dblanding/PicoBot-oto/imgs/arena_map0.png

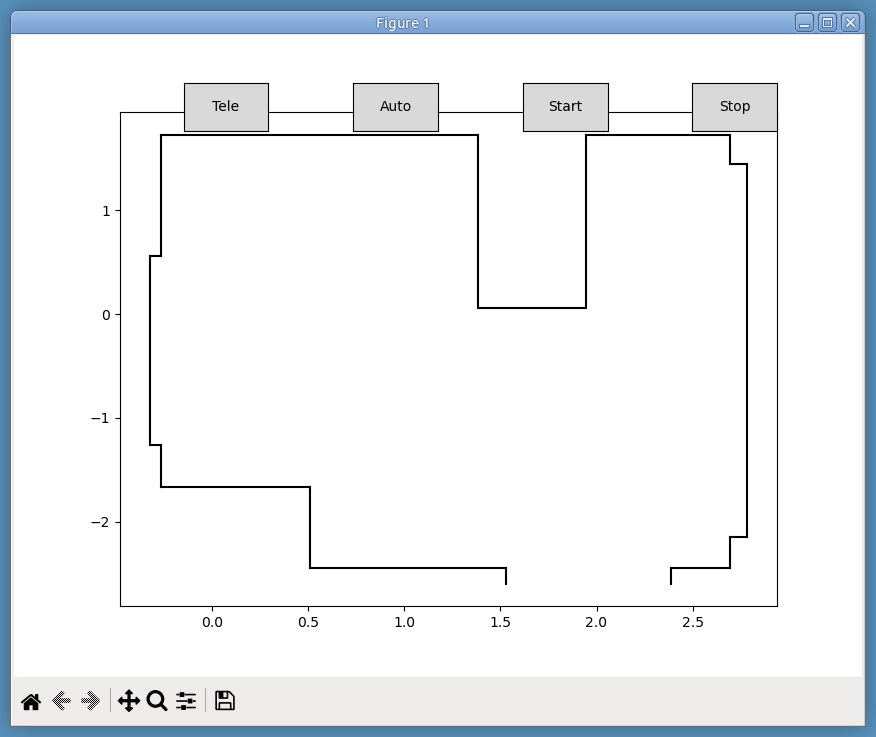
imgs/arena_map0.png
