dblanding/PicoBot-oto/imgs/arena_map1.png

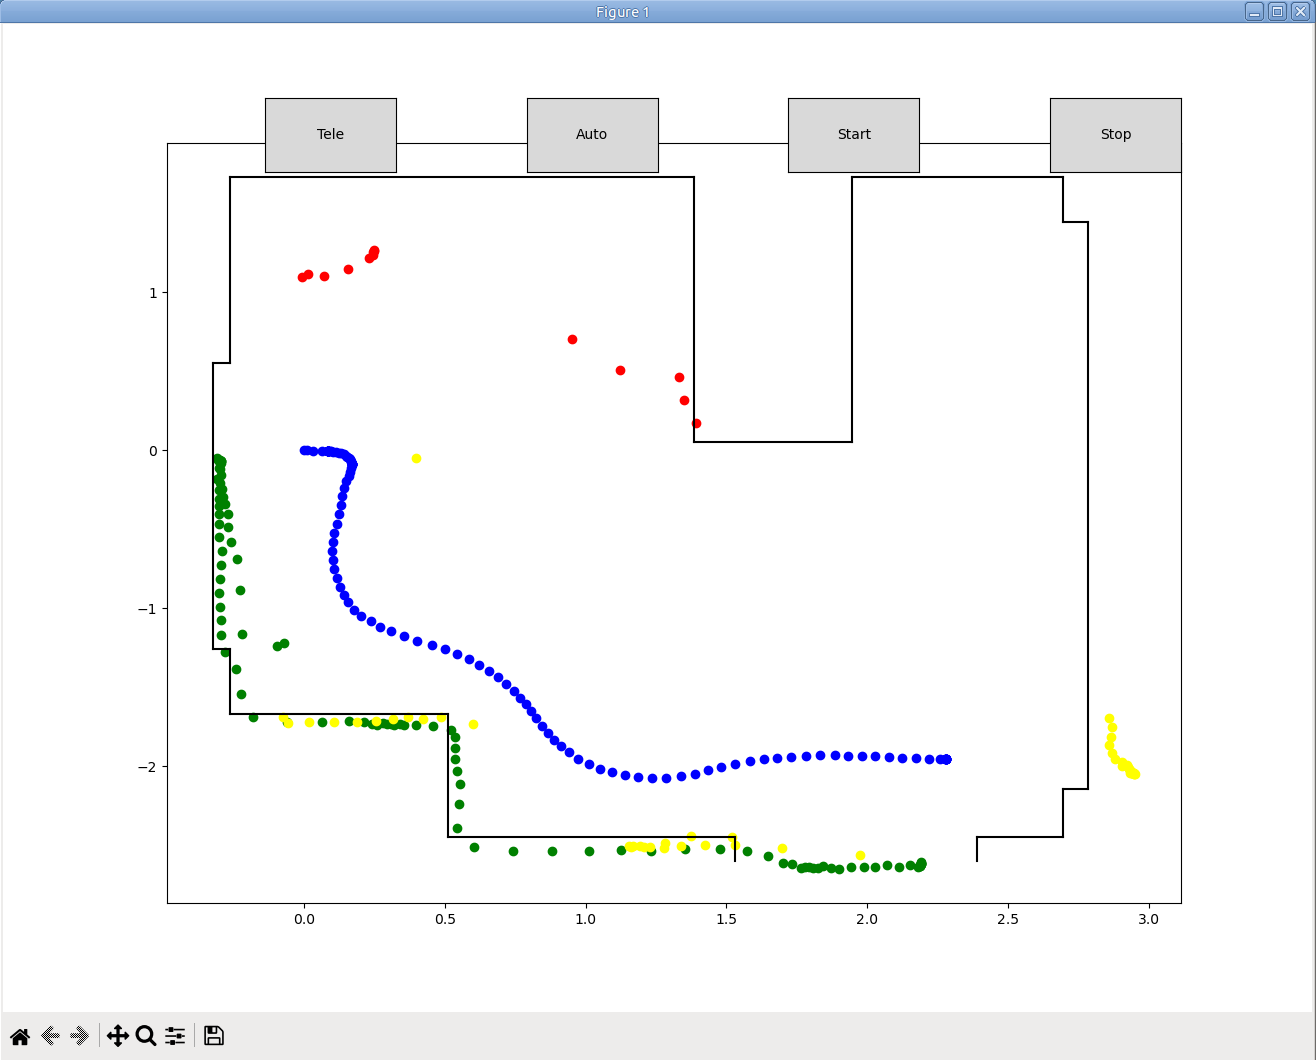
imgs/arena_map1.png
