dblanding/PicoBot-oto/imgs/arena_map2.png

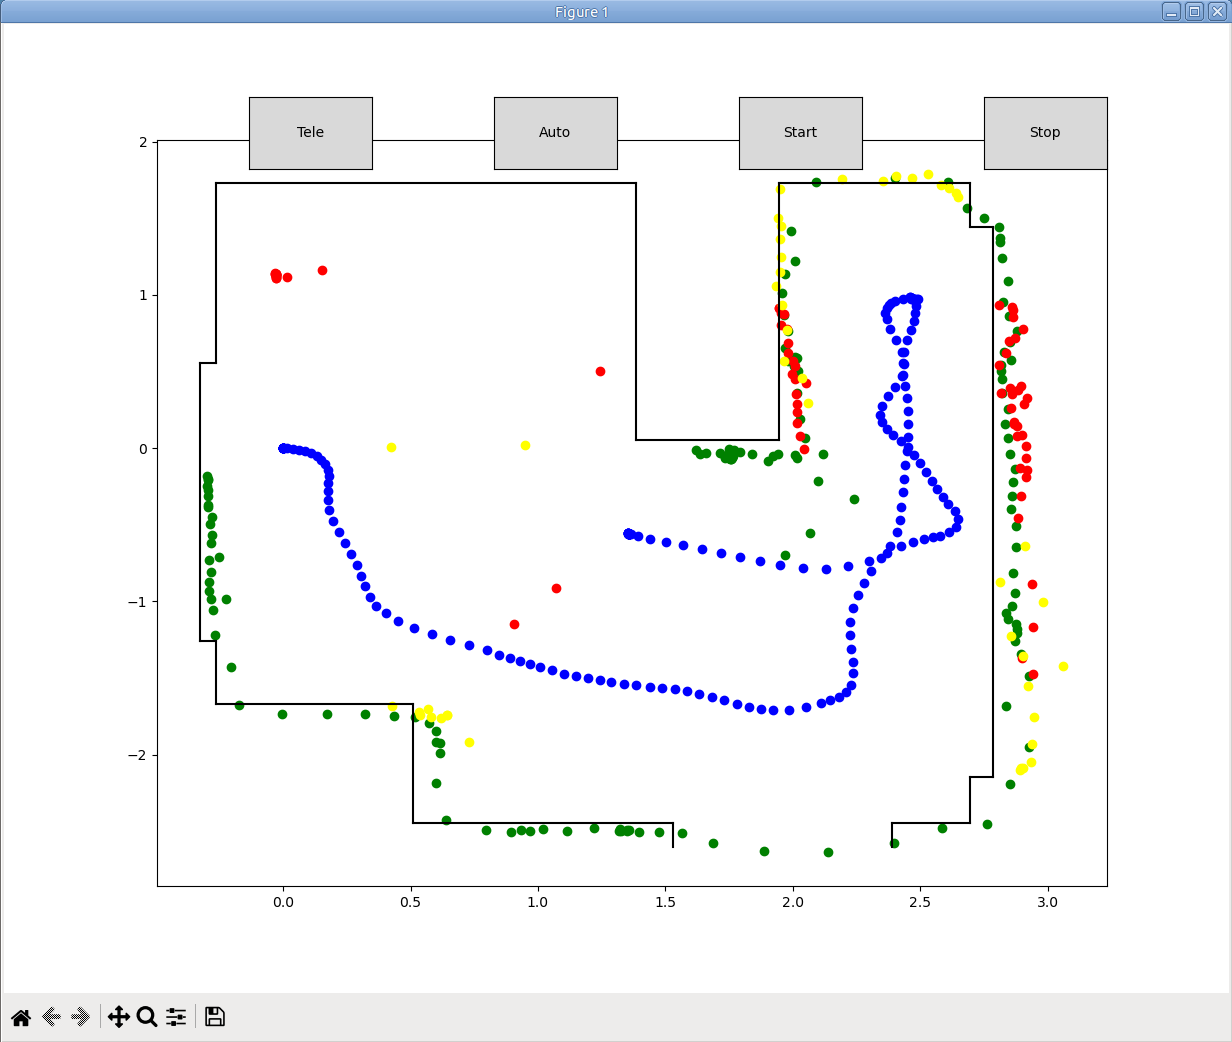
imgs/arena_map2.png
