dblanding/PicoBot-oto/arena/arena_dwg.pdf

4

3

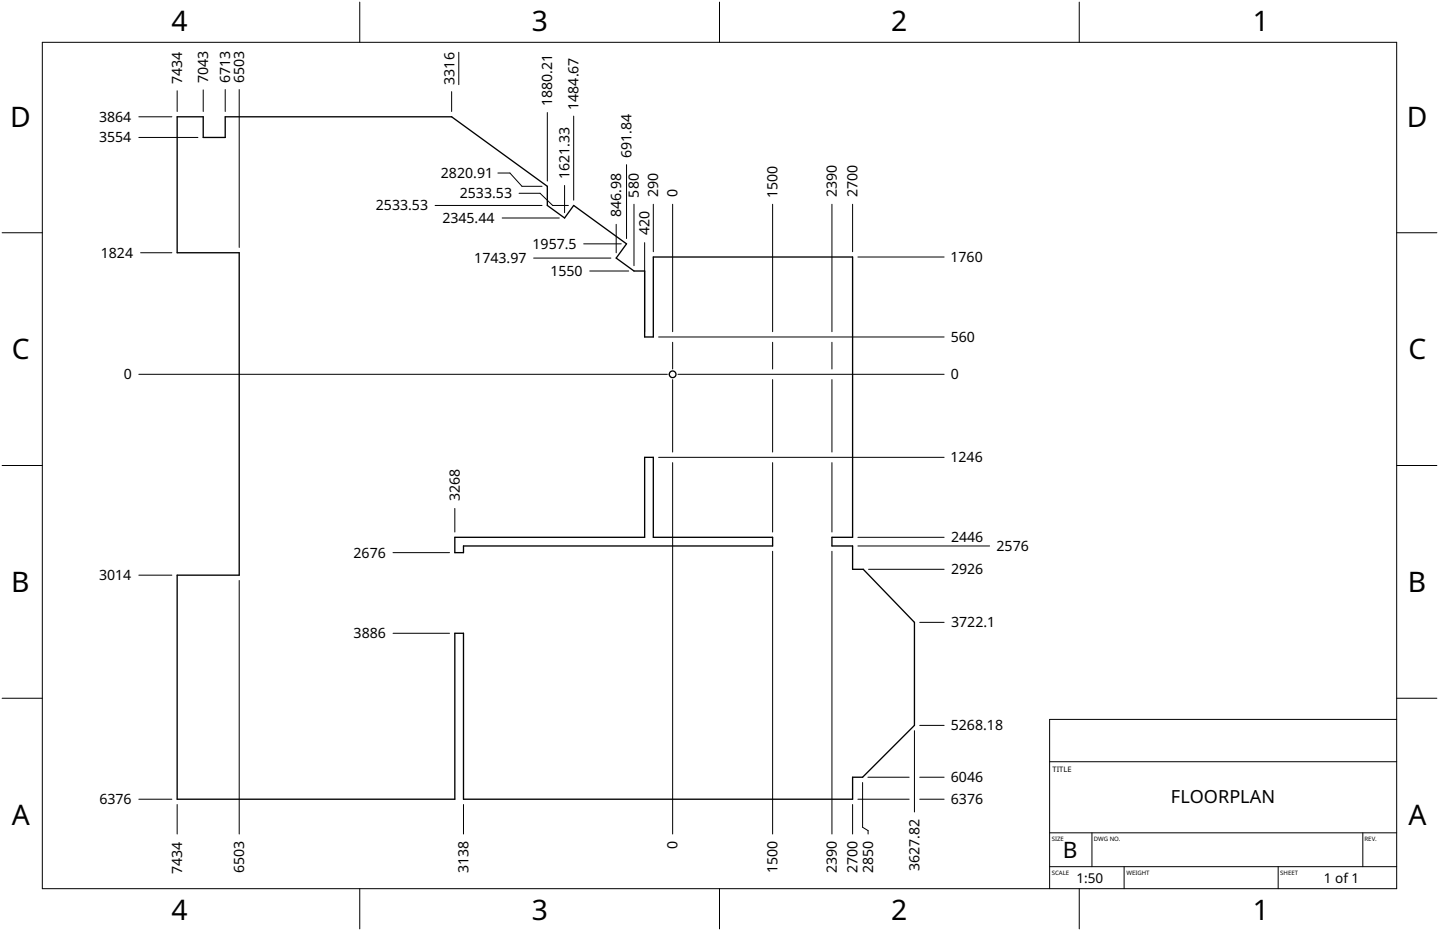
[picture p11: page 1]
TITLE; FLOORPLAN

SIZE B | DWG NO. | REV.

SCALE 1:50 | WEIGHT | SHEET
