dblanding/PicoBot-oto/(list of files, drawings)

Other design files:
pico_power.fzz
