dblanding/PicoBot-oto/(commit log)

2025-03-27 Initial Commit of files
    [pico_power.fzz]
2025-03-31 Add sections to readme: CAD model, otos gap
2025-04-01 update link to CAD model on branch B1
2025-04-12 speed up vcsel distance sensor reads
2025-04-18 Implement bi-directional comm between laptop & robot using single BLE-UART Friend device.
